PhilippSchulzGit/Remote/Cost Breakdown Remote.xlsx

Category | Part | Time | Filament [g] | Count | Price | Sum
 |  |  |  |  |  |  | time | filament | price
3D Prints | RemoteCaseV1 | 2:41:00 | 26 | 1 | 0.66 € | 3.41 € | 0.1118055556 | 26 | 0.66
 | RemoteV1Lid | 12:05:00 | 110 | 1 | 2.75 € |  | 0.5034722222 | 110 | 2.75
Electronics | 4-Achsen Joystick (https://www.amazon.de/gp/product/B088W8D8SB/) | - | - | 2 | 24.36 € | 129.73 € |  |  | 48.72
 | 10x Mini-Kippschalter (https://www.amazon.de/gp/product/B077D9FRGL/) | - | - | 1 | 9.99 € |  |  |  | 9.99
 | 12x Push Button (https://www.amazon.de/gp/product/B075YNQQ8J/) | - | - | 1 | 15.99 € |  |  |  | 15.99
 | 4x Kippschalter (https://www.amazon.de/gp/product/B07KQ2R6G4/) | - | - | 1 | 9.99 € |  |  |  | 9.99
 | 3,7V 2000mAh LiPo Battery (https://www.amazon.de/gp/product/B08214DJLJ/) | - | - | 1 | 14.99 € |  |  |  | 14.99
 | NodeMCU Micro Controller (https://www.amazon.de/gp/product/B074Q2WM1Y) | - | - | 1 | 6.99 € |  |  |  | 6.99
 | ADC Converter Board (https://www.amazon.de/dp/B07PXFD3BH) | - | - | 2 | 5.79 € |  |  |  | 11.58
 | NRF24L01 radio module (https://www.amazon.de/gp/product/B06XJN417D) | - | - | 3 | 2.50 € |  |  |  | 7.49
 | Boost Converter (https://www.amazon.de/gp/product/B079H3YD8V/) | - | - | 1 | 3.99 € |  |  |  | 3.99
 |  |  |  |  | Sum | 133.14 €
