PhilippSchulzGit/Remote/CAD/RemoteV1Body.stl

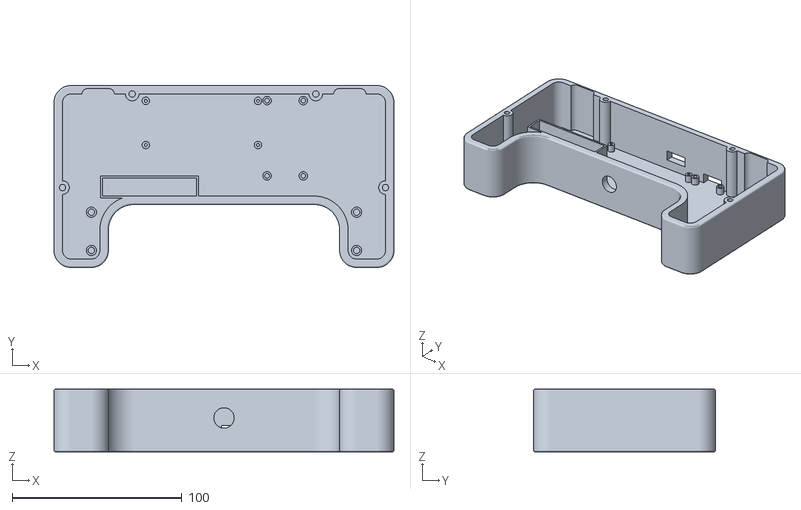
[picture p1: CAD file, 2023-02-17]
CAD/RemoteV1Body.stl
200.0 x 107.0 x 37.0
