PhilippSchulzGit/Remote/CAD/Remote.FCStd

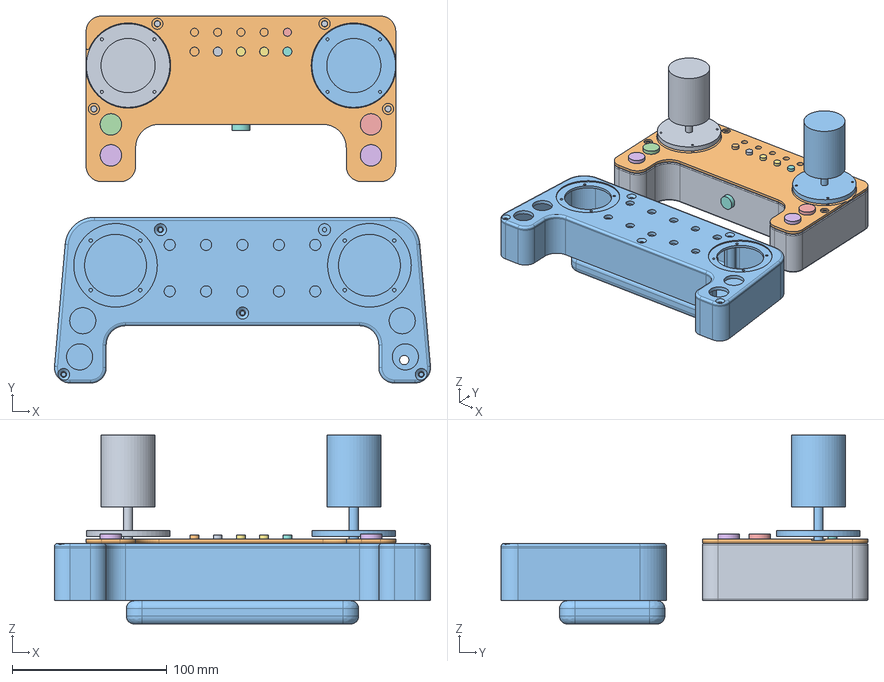
[picture p2: CAD file, 2023-02-17]
CAD/Remote.FCStd
242.9 x 237.0 x 122.0 mm
RemoteV1Body
RemoteV1Lid
Remotev20Bruton
Battery
MicroControllerModel
Button1
SwitchSmall1
Switch2
JoyStick
PCB
JoyStick2
Button2
Button3
Button4
SwitchSmall2
SwitchSmall3
SwitchSmall4
SwitchSmall5
ADCBoard1
ADCBoard2
