PhilippSchulzGit/Remote/(list of files, drawings)

Other design files:
Electrical Documents/Remote Wiring Diagram.fzz
