PhilippSchulzGit/Remote/Electrical Documents/Remote Wiring Diagram.jpg

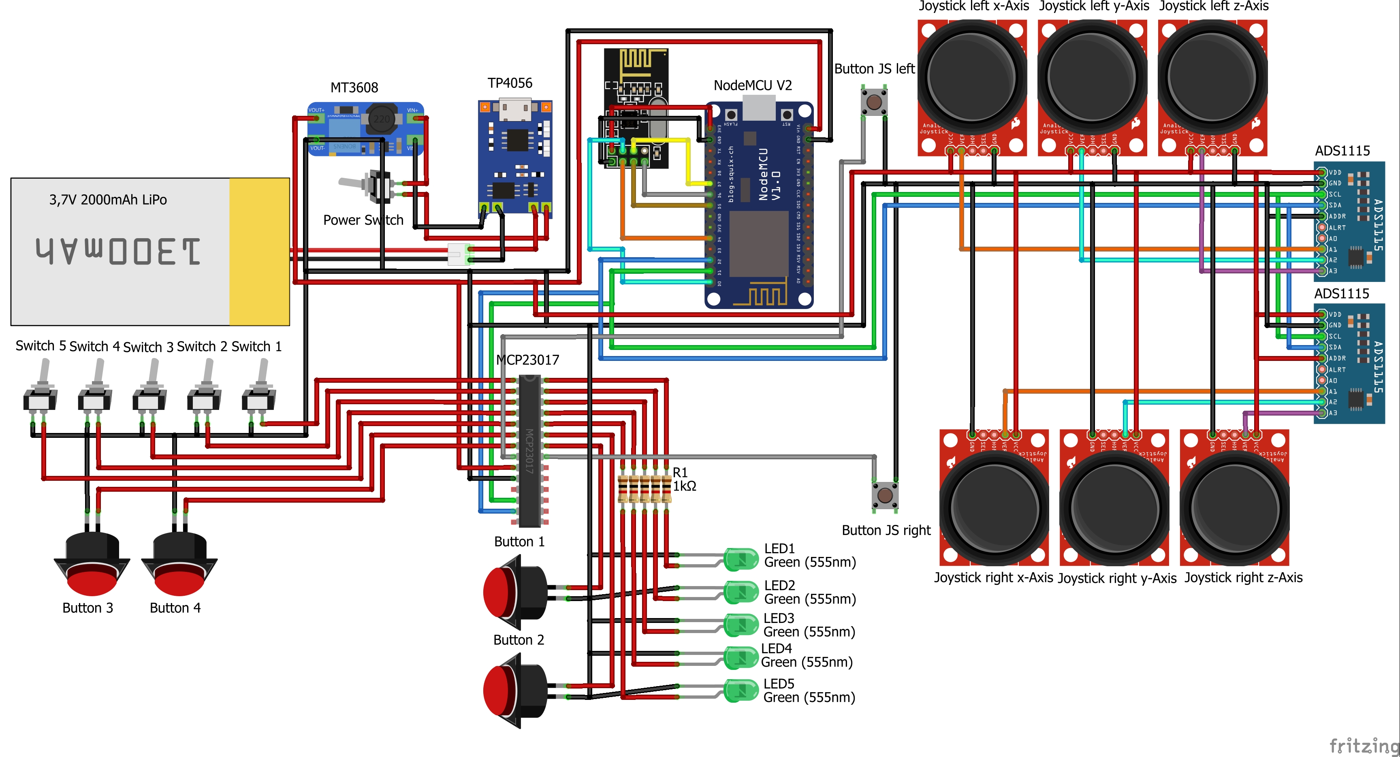
Electrical Documents/Remote Wiring Diagram.jpg
