PhilippSchulzGit/Remote/(commit log)

2023-02-17 Initial upload
    Collected CAD, Code, and wiring diagram stuff for repository
    [Cost Breakdown Remote.xlsx, Remote Wiring Diagram.fzz, Remote.FCStd, RemoteV1Body.stl, RemoteV1Lid.stl]
2023-03-11 Updated Wiring Diagram
    [Remote Wiring Diagram.fzz]
